guolivar/ODIN/README.md

ODIN
====
Outdoor Dust Information Node (ODIN)
