guolivar/ODIN/ODIN PCB/ODIN PCB/ODIN PCB.kicad_pcb

## KiCad design ODIN PCB/ODIN PCB/ODIN PCB.kicad_pcb (2015-05-15)

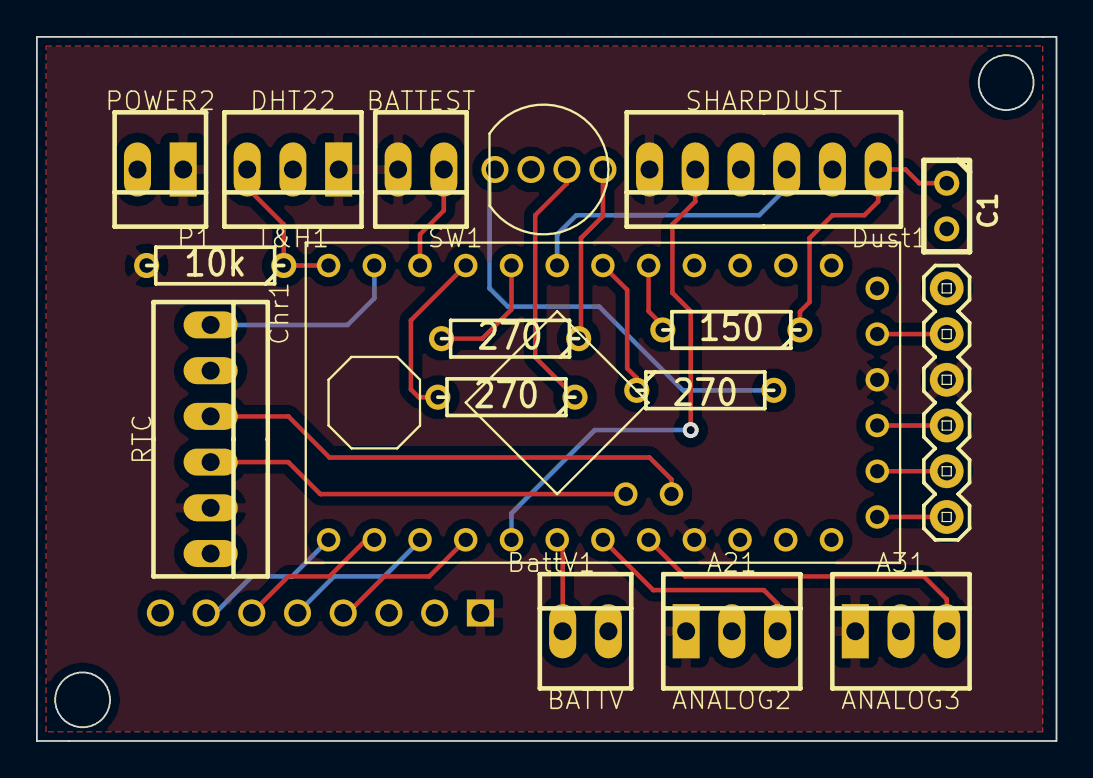
[picture p1: board ODIN PCB.kicad_pcb from above]

Board: 2 copper layers, 56.6 x 39.1 mm, 18 parts (1 on the bottom side), 28 nets.

Parts:
A21: ANALOG2; header3
A31: ANALOG3; header3
APM1: ARDUINO_PROMINI; Halley-ARDUINO_PRO_MINI
BattV1: BATTV; PINHEAD1-2
C1: 220u; C1
Chr1: RTC; PINHEAD1-6
Dust1: SHARPDUST; PINHEAD1-6
GUS1: RGBLED; SparkFun-LED-TRICOLOR-THROUGHHOLE
JP1: FTDI_BASICPTH; SparkFun-FTDI_BASIC
P1: POWER2; conn2pwr
R1: 10k; R3
R2, R3, R4: 270; R3
R5: 150; R3
SD1: MICRO-SD; microSD
SW1: BATTEST; PINHEAD1-2
T&H1: DHT22; header3

Connections:
/A0: APM1.A0, Dust1.5
/A1: APM1.A1, BattV1.1
/A2: A21.3, APM1.A2
/A3: A31.3, APM1.A3
/CLK: APM1.D13, SD1.5
/CS: APM1.D10, SD1.2
/CTS: APM1.CTS, JP1.CTS
/D0: APM1.TXO, JP1.RXI
/D1: APM1.RXI, JP1.TXO
/D2: APM1.D2, R5.2
/D3: APM1.D3, R2.1
/D4: APM1.D4, Dust1.3
/D5: APM1.D5, R3.2
/D6: APM1.D6, R4.2
/D7: APM1.D7, SW1.1
/D9: APM1.D9, R1.1, T&H1.3
/DI: APM1.D11, SD1.3
/DO: APM1.D12, SD1.4
/DTR: APM1.GRN, JP1.DTR
/GND: A21.GND, A31.GND, APM1.GND1, BattV1.2, C1.2, Chr1.6, Dust1.2, Dust1.4, GUS1.GND, JP1.GND, P1.GND, SD1.6, T&H1.GND
/SCL: APM1.A4, Chr1.4
/SDA: APM1.A5, Chr1.3
/SQW: APM1.D8, Chr1.1
/VCC: A21.VCC, A31.VCC, APM1.VCC1, APM1.VCC2, Chr1.5, Dust1.6, JP1.VCC, P1.VCC, R1.2, SD1.8, SW1.2, T&H1.VCC
unnamed: GUS1.RED, R2.2
unnamed: GUS1.GRN, R3.1
unnamed: GUS1.BLU, R4.1
unnamed: C1.1, Dust1.1, R5.1
