guolivar/ODIN/ODIN PCB/ODIN PCB/0.02inch solder mask relief BCu.PNG

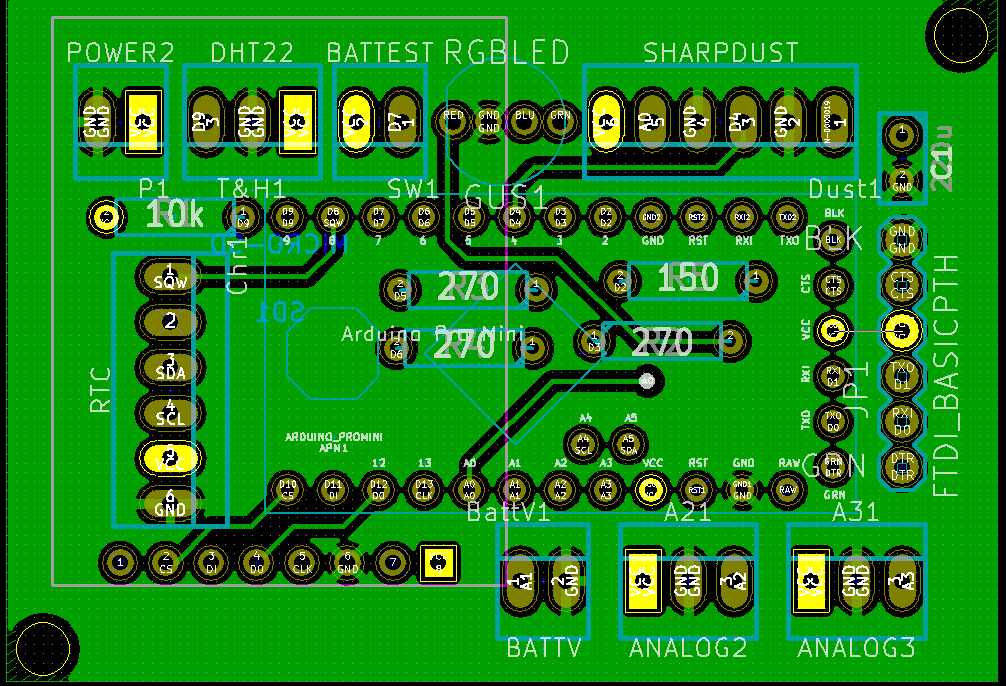
ODIN PCB/ODIN PCB/0.02inch solder mask relief BCu.PNG
