guolivar/ODIN/ODIN PCB/ODIN PCB/0.02inch solder mask relief FCu.PNG

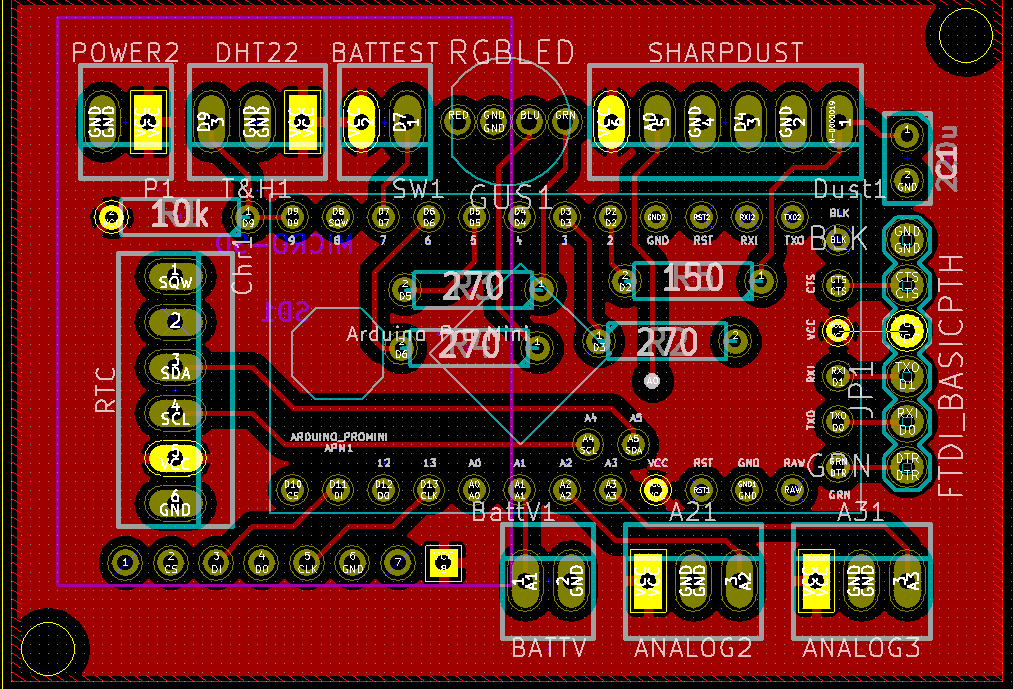
ODIN PCB/ODIN PCB/0.02inch solder mask relief FCu.PNG
