guolivar/ODIN/ODIN PCB/ODIN PCB/0.03inch solder mask relief FCu.PNG

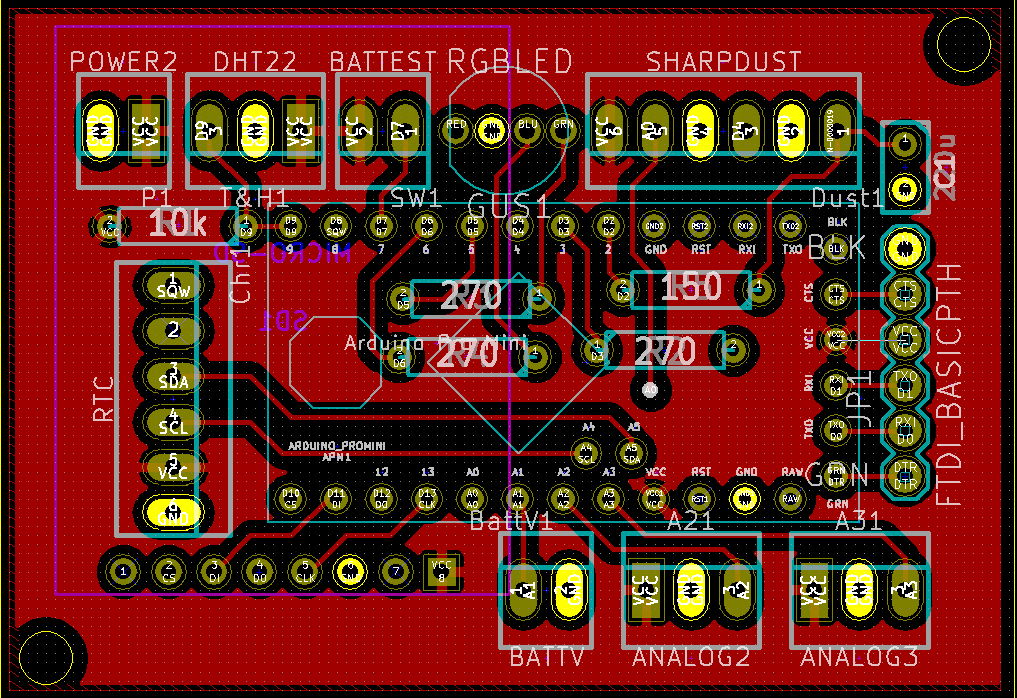
ODIN PCB/ODIN PCB/0.03inch solder mask relief FCu.PNG
