guolivar/ODIN/(commit log)

2014-07-09 PCB design first commit. Working schematic with no traces on the PCB.
    [ODIN PCB.kicad_pcb, ODIN PCB.sch]
2014-07-14 Next iteration. Better net labelling. From Sam's message: "I've got it down to about 40mm x 56 mm. Probably needs checking for connectivity issues and errors. It passed the KiCad design rules check. 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
    [ODIN PCB.kicad_pcb, ODIN PCB.sch]
2014-08-21 Dust trigger pin changed to 4 on new ODIN PCB
2014-08-21 Interrupt pinmode set to INPUT_PULLUP
2014-08-28 Swapped SDA/SCL pins, moved RTC alarm trigger to Arduino pin 2 interrupt. RGB led leg on pin 2 moved to pin 8. Libraries added as some parts within libraries modified.
    [ODIN PCB.kicad_pcb, ODIN PCB.sch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]
2014-08-28 ODIN sleeps until interrupt on pin 2 is triggered. RTC alarm provides interrupt. RTC no longer connected to pin 8.
2014-08-29 Added arduino sleep. Alarm from RTC used as interrupt on pin 2 to wake arduino. RTC alarm no longer connected to pin 8.
    [Outdoor_PACMAN_code_modified.ino]
2015-05-15 Changed tree to make it easier to work with Kicad
2015-09-03 20 1s dust samples per minute and an indication of memory card status on LED (pin 13)
2015-09-07 Potential error on Arduino 1.0.6 declaring counters in the for cycle definition. Memory card initialisation status light fixed.
    [Outdoor_PACMAN_code_modified.ino]
2015-10-08 Fixed bug where ODIN would fail to wake up because of bad timing in the start sequence
    [Outdoor_PACMAN_code_modified.ino]
2015-10-08 Dirty merge
    [ODIN PCB.kicad_pcb, ODIN PCB.sch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]
2016-04-07 Libraries updated
    [ODIN PCB.sch]
